gdf93/KeetV2HW/costo_scheda_power_keet_car.xlsx

sezione POWER
 |  |  |  |  |  |  |  |  |  | nuovo componente
schematico | codice mouser | Unitario x100 | Unitario x1000 | note | tot x100 | Colonna1 | totx1000 | note2
M1 | DMPH6250SQ-7 | 0.191 € | 0.128 € |  | 19.10 € |  | 128.00 €
R6 | CRCW040210K0FKEDC | 0.011 € | 0.004 € |  | 1.10 € |  | 4.00 € |  |  | s
Z1 | BZX84C10LT1G | 0.032 € | 0.022 € |  | 3.20 € |  | 22.00 €
R2 | CRCW04026M80FKED | 0.012 € | 0.011 € |  | 1.20 € |  | 11.00 € |  |  | s
R4 | CR0402-FX-1872GLF | 0.005 € | 0.004 € |  | 0.50 € |  | 4.00 € |  |  | s
C3-C11-C12 | TMK107BBJ475MA-T | 0.090 € | 0.069 € | 3 compon. | 27.00 € |  | 207.00 € | valore moltiplicato anche per 3. (sono 3 componenti) |  | s
C2 | C1005X5R1H104K050BB | 0.027 € | 0.019 € |  | 2.70 € |  | 19.00 €
C1 | GRM155R71C104KA88D | 0.008 € | 0.005 € |  | 0.80 € |  | 5.00 €
C6 | CL10A225KP8NNNC | 0.023 € | 0.013 € |  | 2.30 € |  | 13.00 €
R3 | CR0402-FX-1872GLF | 0.013 € | 0.010 € |  | 1.30 € |  | 10.00 € |  |  | s
IC1 | LMR23615DRRR | 1.800 € | 1.300 € |  | 180.00 € |  | 1300.00 €
L1 | IFSC1515AHER4R7M01 | 0.284 € | 0.227 € |  | 28.40 € |  | 227.00 €
C4 | GRM1555C1H510JA01D | 0.022 € | 0.009 € | reel x1000 | 2.20 € |  | 9.00 €
R1 | CRCW040288K7FKEDHP | 0.000 € | 0.000 € | NO STOCK | 0.00 € |  | 0.00 € |  |  | s
R5 | CRCW040222K1FKED | 0.012 € | 0.004 € |  | 1.20 € |  | 4.00 € |  |  | s
C5 | GRM31CR61A476KE15L | 0.289 € | 0.209 € |  | 28.90 € |  | 209.00 €
C9 | EMK105BJ105KVHF | 0.025 € | 0.013 € |  | 2.50 € |  | 13.00 €
D1 | BAT54CLT1G | 0.034 € | 0.024 € |  | 3.40 € |  | 24.00 €
IC2 | TLV75740PDRVR | 0.308 € | 0.184 € |  | 30.80 € |  | 184.00 €
C10 | TMK105CBJ225KV-F | 0.057 € | 0.042 € |  | 5.70 € |  | 42.00 €
C7 | GRM155R60J475ME87D | 0.041 € | 0.024 € |  | 4.10 € |  | 24.00 €
IC4 | MCP73831T-2ACI_MC | 0.381 € | 0.381 € | no x1000 | 38.10 € |  | 381.00 €
R7 | CRCW040218K0FKED | 0.012 € | 0.004 € |  | 1.20 € |  | 4.00 € |  |  | s
R8 | CRCW0402100KFKEDC | 0.011 € | 0.004 € |  | 1.10 € |  | 4.00 € |  |  | s
M2 | DMP1045U-7 | 0.123 € | 0.086 € |  | 12.30 € |  | 86.00 €
IC3 | S-1011EA0-M6T1U4 | 0.512 € | 0.355 € |  | 51.20 € |  | 355.00 €
C8 | GRM155R71H472JA01J | 0.013 € | 0.008 € |  | 1.30 € |  | 8.00 €
R9 |  |  |  |  | 0.00 € |  | 0.00 € |  |  | s
 |  |  | dimensione ordine: |  | 100 unità |  | 1000 unità
 |  |  | totale ordine: |  | 451.60 € |  | 3297.00 € | -26.99291408% | risparmio economia di scala
 |  |  | costo unitario: |  | 4.52 € |  | 3.30 €
sezione OBD | PART NUMBER(NO MOUSER PART…)
schematico | part number | unitario x100 | unitario x1000 | note | tot x100 | Colonna7 | tot x1000
connettore OBD |  | 0.82 € | 0.74 € |  | 82.00 € |  | 740.00 €
C33-C34 | CC0402KRX7R9BB561 | 0.009 € | 0.008 € | 2 | 1.80 € |  | 16.00 €
R33-R34 | ERJ-2RHD1000X | 0.030 € | 0.014 € | 2 | 6.00 € |  | 28.00 €
IC7 | TJF1051T/3 | 0.477 € | 0.352 € |  | 47.70 € |  | 352.00 €
C31-C32-C27-C23-C24-C25 | EMK105BJ105KVHF | 0.025 € | 0.013 € | 6 | 15.00 € |  | 78.00 €
IC6 | LPC1517JBD48E | 3.150 € | 2.380 € |  | 315.00 € |  | 2380.00 €
C28-C30 | 04025A100JAT2A | 0.012 € | 0.007 € | 2 | 2.40 € |  | 14.00 €
Y2 | ECS-120-10-36B-CWY-TR | 0.246 € | 0.197 € | reelx1000 | 24.60 € |  | 197.00 €
U1 | AP7313-33SRG-7 | 0.113 € | 0.085 € |  | 11.30 € |  | 85.00 €
R35 | CRCW040247K0FKED | 0.012 € | 0.004 € |  | 1.20 € |  | 4.00 €
R36-R37 | TNPW040210K0DEED | 0.141 € | 0.078 € | 2 | 28.20 € |  | 156.00 €
C35-C36-C26 | C1005X5R1H104K050BB | 0.027 € | 0.019 € | 3 | 8.10 € |  | 57.00 €
P1 | TLV76050DBZT | 0.161 € | 0.111 € |  | 16.10 € |  | 111.00 €
R38-R39 | RC0805FR-070RL | 0.006 € | 0.005 € | 2 | 1.20 € |  | 10.00 €
U2<A:B> | LM393D | 0.142 € | 0.097 € |  | 14.20 € |  | 97.00 €
R40-R41 | RC0402FR-07330RL | 0.003 € | 0.003 € | 2 | 0.60 € |  | 6.00 €
DS1 | HSMS-C190 | 0.108 € | 0.080 € |  | 10.80 € |  | 80.00 €
DS2 | HSMY-C190 | 0.108 € | 0.080 € |  | 10.80 € |  | 80.00 €
R32 | CRCW0402510RFKEDC | 0.011 € | 0.004 € |  | 1.10 € |  | 4.00 €
U3 | MCP2021-500E/SN | 0.805 € | 0.805 € |  | 80.50 € |  | 805.00 €
C29 | GRM155R60J106ME05J | 0.044 € | 0.025 € |  | 4.40 € |  | 25.00 €
R26-R27 | ERJ-2RKF3301X | 0.008 € | 0.003 € | 2 | 1.60 € |  | 6.00 €
R28-R29-R31-R30 | TNPW040210K0DEED | 0.141 € | 0.078 € | 4 | 56.40 € |  | 312.00 €
D4 | BAT46W-7-F | 0.113 € | 0.069 € |  | 11.30 € |  | 69.00 €
Q5 | BSS84LT1G | 0.067 € | 0.047 € |  | 6.70 € |  | 47.00 €
Q6-Q7 | BSS138 | 0.062 € | 0.042 € | 2 | 12.40 € |  | 84.00 €
 |  |  | dimensione ordine: |  | 100 unità |  | 1000 unità
 |  |  | totale ordine: |  | 771.40 € |  | 5843.00 € | -24.25460202% | risparmio economia di scala
 |  |  | costo unitario: |  | 7.71 € |  | 5.84 €
sezione CONTROL
schematico | part number | unitario x100 | unitario x1000 | Colonna1 | tot x100 | Colonna7 | tot x1000
LED1 | 150060RS75000 | 0.097 € | 0.097 € |  | 9.70 € |  | 97.00 €
R13-R17-R21-R18 | Panasonic ERJ-2RKF4701X | 0.008 € | 0.004 € | 4 | 3.20 € |  | 16.00 €
Q1-Q3 | ON Semiconductor BC850CLT1G | 0.028 € | 0.019 € | 2 | 5.60 € |  | 38.00 €
R14-R20-R16-R22 | Vishay CRCW040247K0FKED | 0.012 € | 0.004 € | 4 | 4.80 € |  | 16.00 €
R12 | Panasonic ERJ-2RKF1500X | 0.008 € | 0.003 € |  | 0.80 € |  | 3.00 €
R15 | Vishay CRCW0402-10K0FKED | 0.012 € | 0.005 € |  | 1.20 € |  | 5.00 €
Y1 | XRCHA16M000F0A12R0 | 0.387 € | 0.309 € |  | 38.70 € |  | 309.00 €
C16-C22-C13-C14-C15-C17-C14 | EMK105BJ105KVHF | 0.025 € | 0.013 € | 7 | 17.50 € |  | 91.00 €
C18-C19 | GRM1551X1H8R0DA01D | 0.239 € | 0.195 € | 2.no mouse | 47.80 € |  | 390.00 €
R19 | Yageo RC0402FR-072K4L | 0.003 € | 0.003 € |  | 0.30 € |  | 3.00 €
R23 | TE Connectivity CRG0402F5K6 | 0.002 € | 0.002 € |  | 0.20 € |  | 2.00 €
R24-R25 | Yageo RC0402FR-132K2L | 0.003 € | 0.003 € | 2 | 0.60 € |  | 6.00 €
R10 | ERJ-2RKD1203X | 0.035 € | 0.019 € |  | 3.50 € |  | 19.00 €
R11 | ERJ-2RHD3902X | 0.023 € | 0.014 € |  | 2.30 € |  | 14.00 €
D2 | ON Semiconductor MM3Z3V9ST1G | 0.032 € | 0.022 € |  | 3.20 € |  | 22.00 €
IC5 | ATMEGA1284P-MU | 3.720 € | 3.720 € |  | 372.00 € |  | 3720.00 €
Q2 | Diodes DMP1045U-7 | 0.123 € | 0.086 € |  | 12.30 € |  | 86.00 €
D3 | 02SSL20L | 0.039 € | 0.039 € |  | 3.90 € |  | 39.00 €
C20 | Samsung CL10B104JO8NNND | 0.003 € | 0.003 € |  | 0.30 € |  | 3.00 €
C21 | Samsung CL10A106KP8NNND | 0.025 € | 0.025 € |  | 2.50 € |  | 25.00 €
 |  |  | dimensione ordine: |  | 100 unità |  | 1000 unità
 |  |  | totale ordine: |  | 530.40 € |  | 4904.00 € | -7.54147813% | risparmio economia di scala
 |  |  | costo unitario: |  | 5.30 € |  | 4.90 €
 |  |  |  |  |  |  |  |  | resoconto finale: somma dei contributi di tutte le sezioni
 |  |  |  |  |  |  |  |  | dimensione ordine: | 100 unità | 1000 unità
 |  |  |  |  |  |  |  |  | totale ordine: | 1753.40 € | 14044.00 €
 |  |  |  |  |  |  |  |  | costo unitario: | 17.53 € | 14.04 €
