gdf93/KeetV2HW/connettore_OBD_pin_invertiti.SLDASM

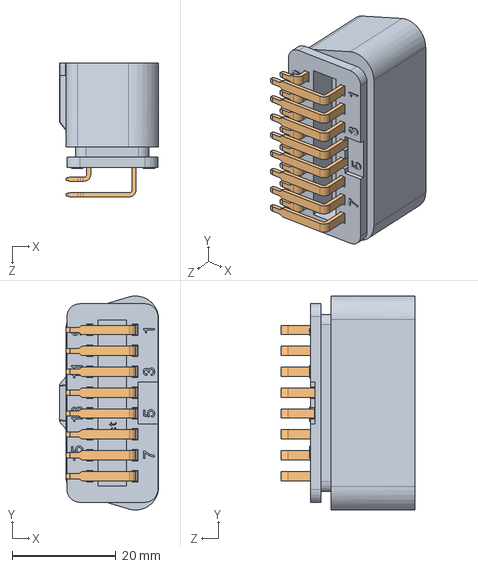
[picture p1: CAD file, 2021-03-10]
connettore_OBD_pin_invertiti.SLDASM
19.1 x 41.2 x 25.7 mm
corpo_principale
pin
