gdf93/KeetV2HW/modelli-pogo/mill-max-827-22-010-10-020101.sldasm

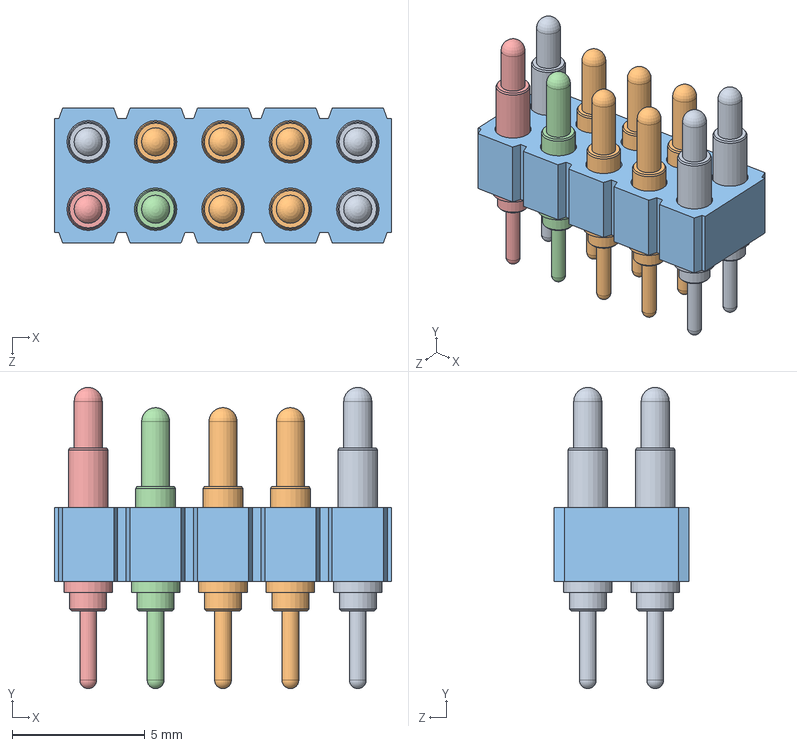
[picture p2: CAD file, 2021-02-11]
modelli-pogo/mill-max-827-22-010-10-020101.sldasm
12.7 x 11.4 x 5.08 mm
mill-max-827-22-010-10-020101_P4XX-28-010-00-090000
mill-max-827-22-010-10-020101_0914-0 x 6
mill-max-827-22-010-10-020101_0914-1 x 4
