gdf93/KeetV2HW/modelli-pogo/mill-max-827-22-010-10-020101_0914-0.sldprt

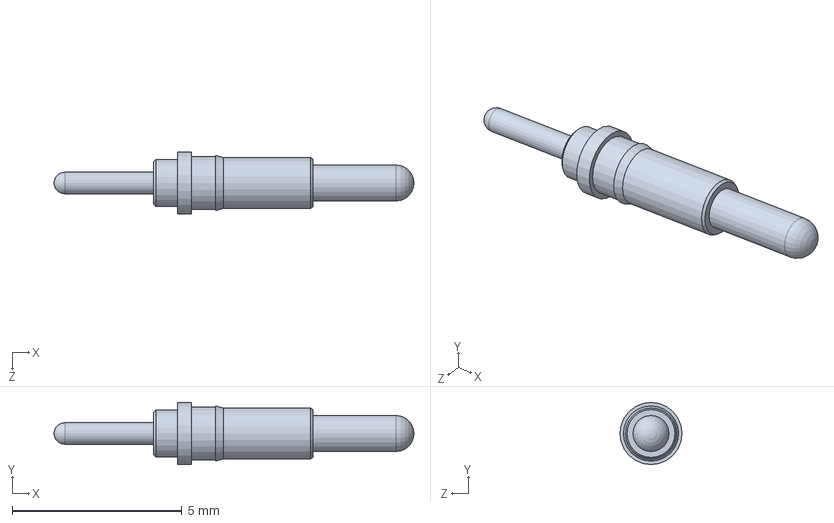
[picture p3: CAD file, 2021-02-11]
modelli-pogo/mill-max-827-22-010-10-020101_0914-0.sldprt
10.6 x 1.83 x 1.83 mm
