gdf93/KeetV2HW/modelli-pogo/mill-max-827-22-010-10-020101_0914-1.sldprt

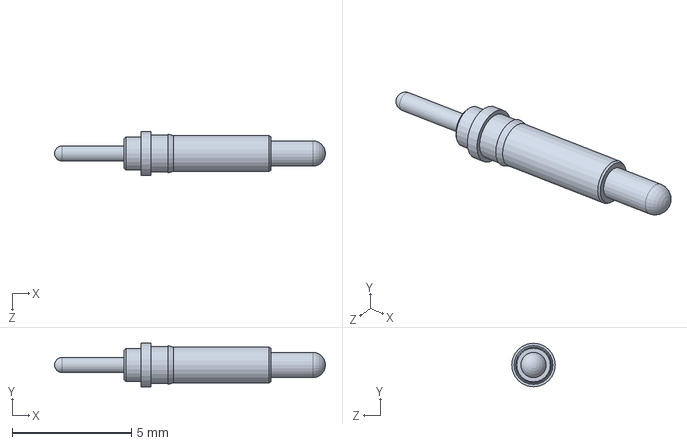
[picture p4: CAD file, 2021-02-11]
modelli-pogo/mill-max-827-22-010-10-020101_0914-1.sldprt
11.4 x 1.83 x 1.83 mm
