gdf93/KeetV2HW/modelli-pogo/mill-max-827-22-010-10-020101_P4XX-28-010-00-090000.sldprt

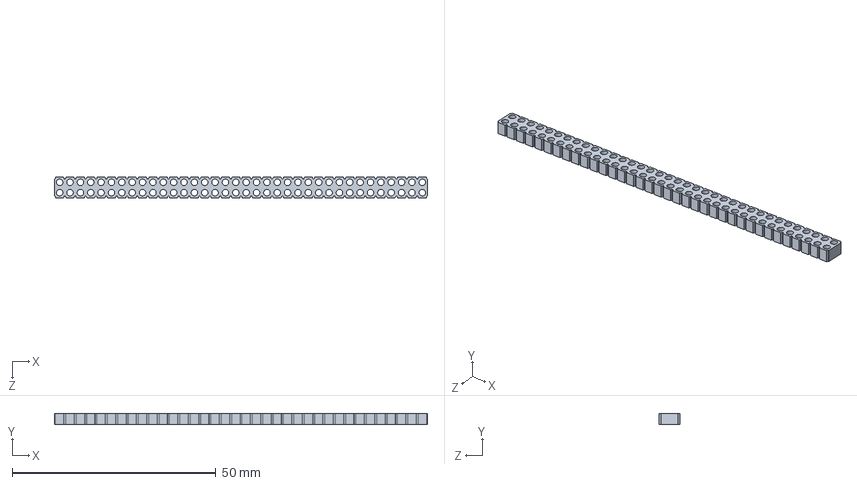
[picture p5: CAD file, 2021-02-11]
modelli-pogo/mill-max-827-22-010-10-020101_P4XX-28-010-00-090000.sldprt
91.4 x 2.79 x 5.08 mm
