gdf93/KeetV2HW/SIM868e_3D.STEP

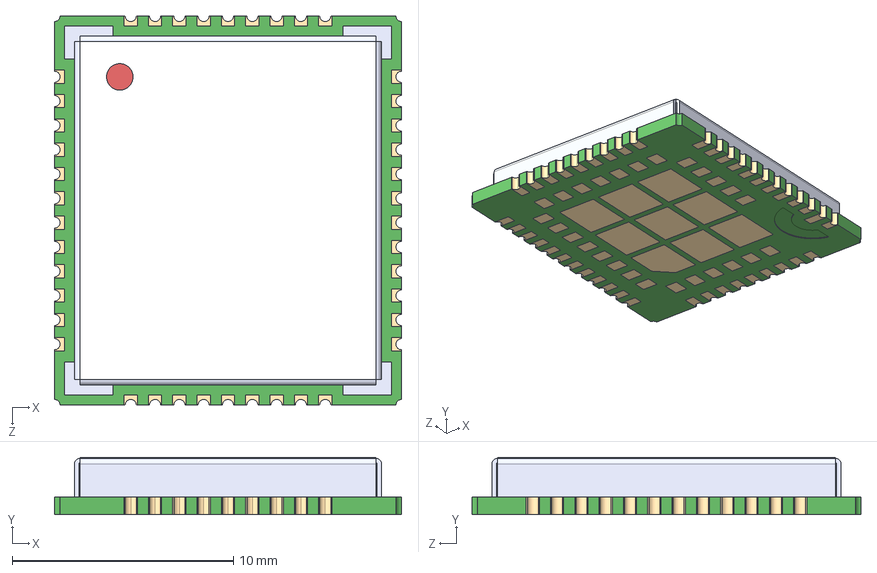
[picture p6: CAD file, 2021-03-07]
SIM868e_3D.STEP
15.7 x 2.60 x 17.6 mm
