gdf93/KeetV2HW/2337019-1.stp

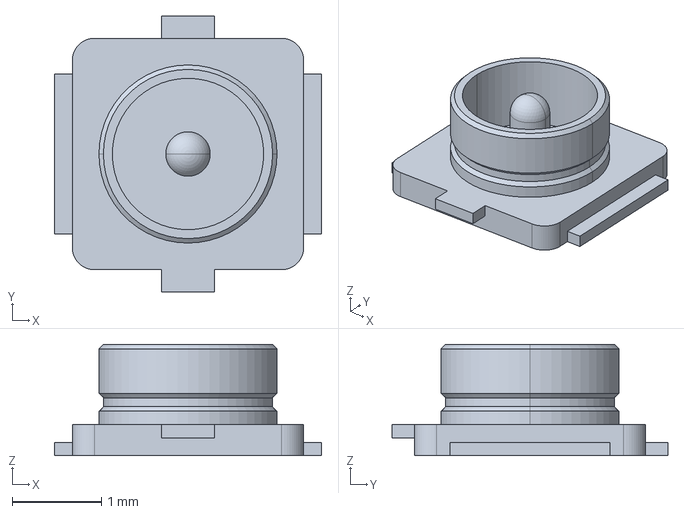
[picture p7: CAD file, 2021-03-07]
2337019-1.stp
3.00 x 3.10 x 1.25 mm
