gdf93/KeetV2HW/(list of files, cad)

Other CAD files:
parte_dell_obdCR-PG016.SLDPRT
mill-max-827-22-010-10-020101.step
connettore_OBD_pin_invertiti.SLDPRT
