gdf93/KeetV2HW/PDNAnalyzer_Output/PowerSupplyV2/Unnamed simulation (1)/Results/vpin2pin.csv

vrefdes | vpin | refdes | pin
VCOMP0 | 0 | Conn1 | 16
VCOMP0 | 1 | Conn1 | 4
VCOMP1 | 0 | M1 | 3
VCOMP1 | 1 | Conn1 | 4
