gdf93/KeetV2HW/PDNAnalyzer_Output/PowerSupplyV2/Unnamed simulation (1)/Results/vcomp2id.csv

vrefdes | id
VCOMP0 | 0
VCOMP1 | 1
