gdf93/KeetV2HW/PDNAnalyzer_Output/PowerSupplyV2/Unnamed simulation (1)/Results/vias.csv

x | y | layer1 | layer2 | voltage1 | voltage2 | current
20.1758 | 988.444 | TOP_LAYER | BOTTOM_LAYER | 0.0005 | 0.0005 | 2.67766e-16
20.1758 | 1016.82 | TOP_LAYER | BOTTOM_LAYER | 0.0005 | 0.0005 | -2.67766e-16
20.1758 | 1045.2 | TOP_LAYER | BOTTOM_LAYER | 0.0005 | 0.0005 | 1.33883e-15
24.1758 | 863.064 | TOP_LAYER | BOTTOM_LAYER | 0.0005 | 0.0005 | 8.03298e-16
24.1758 | 891.444 | TOP_LAYER | BOTTOM_LAYER | 0.0005 | 0.0005 | 1.78511e-16
24.1758 | 919.824 | TOP_LAYER | BOTTOM_LAYER | 0.0005 | 0.0005 | 5.35532e-16
46.1758 | 988.444 | TOP_LAYER | BOTTOM_LAYER | 0.0005 | 0.0005 | 1.78511e-16
46.1758 | 1016.82 | TOP_LAYER | BOTTOM_LAYER | 0.0005 | 0.0005 | -5.35532e-16
46.1758 | 1045.2 | TOP_LAYER | BOTTOM_LAYER | 0.0005 | 0.0005 | 8.92553e-16
47.1758 | 717.824 | TOP_LAYER | BOTTOM_LAYER | 0.0005 | 0.0005 | -1.78511e-15
47.1758 | 748.824 | TOP_LAYER | BOTTOM_LAYER | 0.0005 | 0.0005 | -9.81808e-16
50.1758 | 863.064 | TOP_LAYER | BOTTOM_LAYER | 0.0005 | 0.0005 | 8.92553e-16
50.1758 | 891.444 | TOP_LAYER | BOTTOM_LAYER | 0.0005 | 0.0005 | 4.46277e-16
50.1758 | 919.824 | TOP_LAYER | BOTTOM_LAYER | 0.0005 | 0.0005 | 8.92553e-16
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
