gdf93/KeetV2HW/OBD.pdf

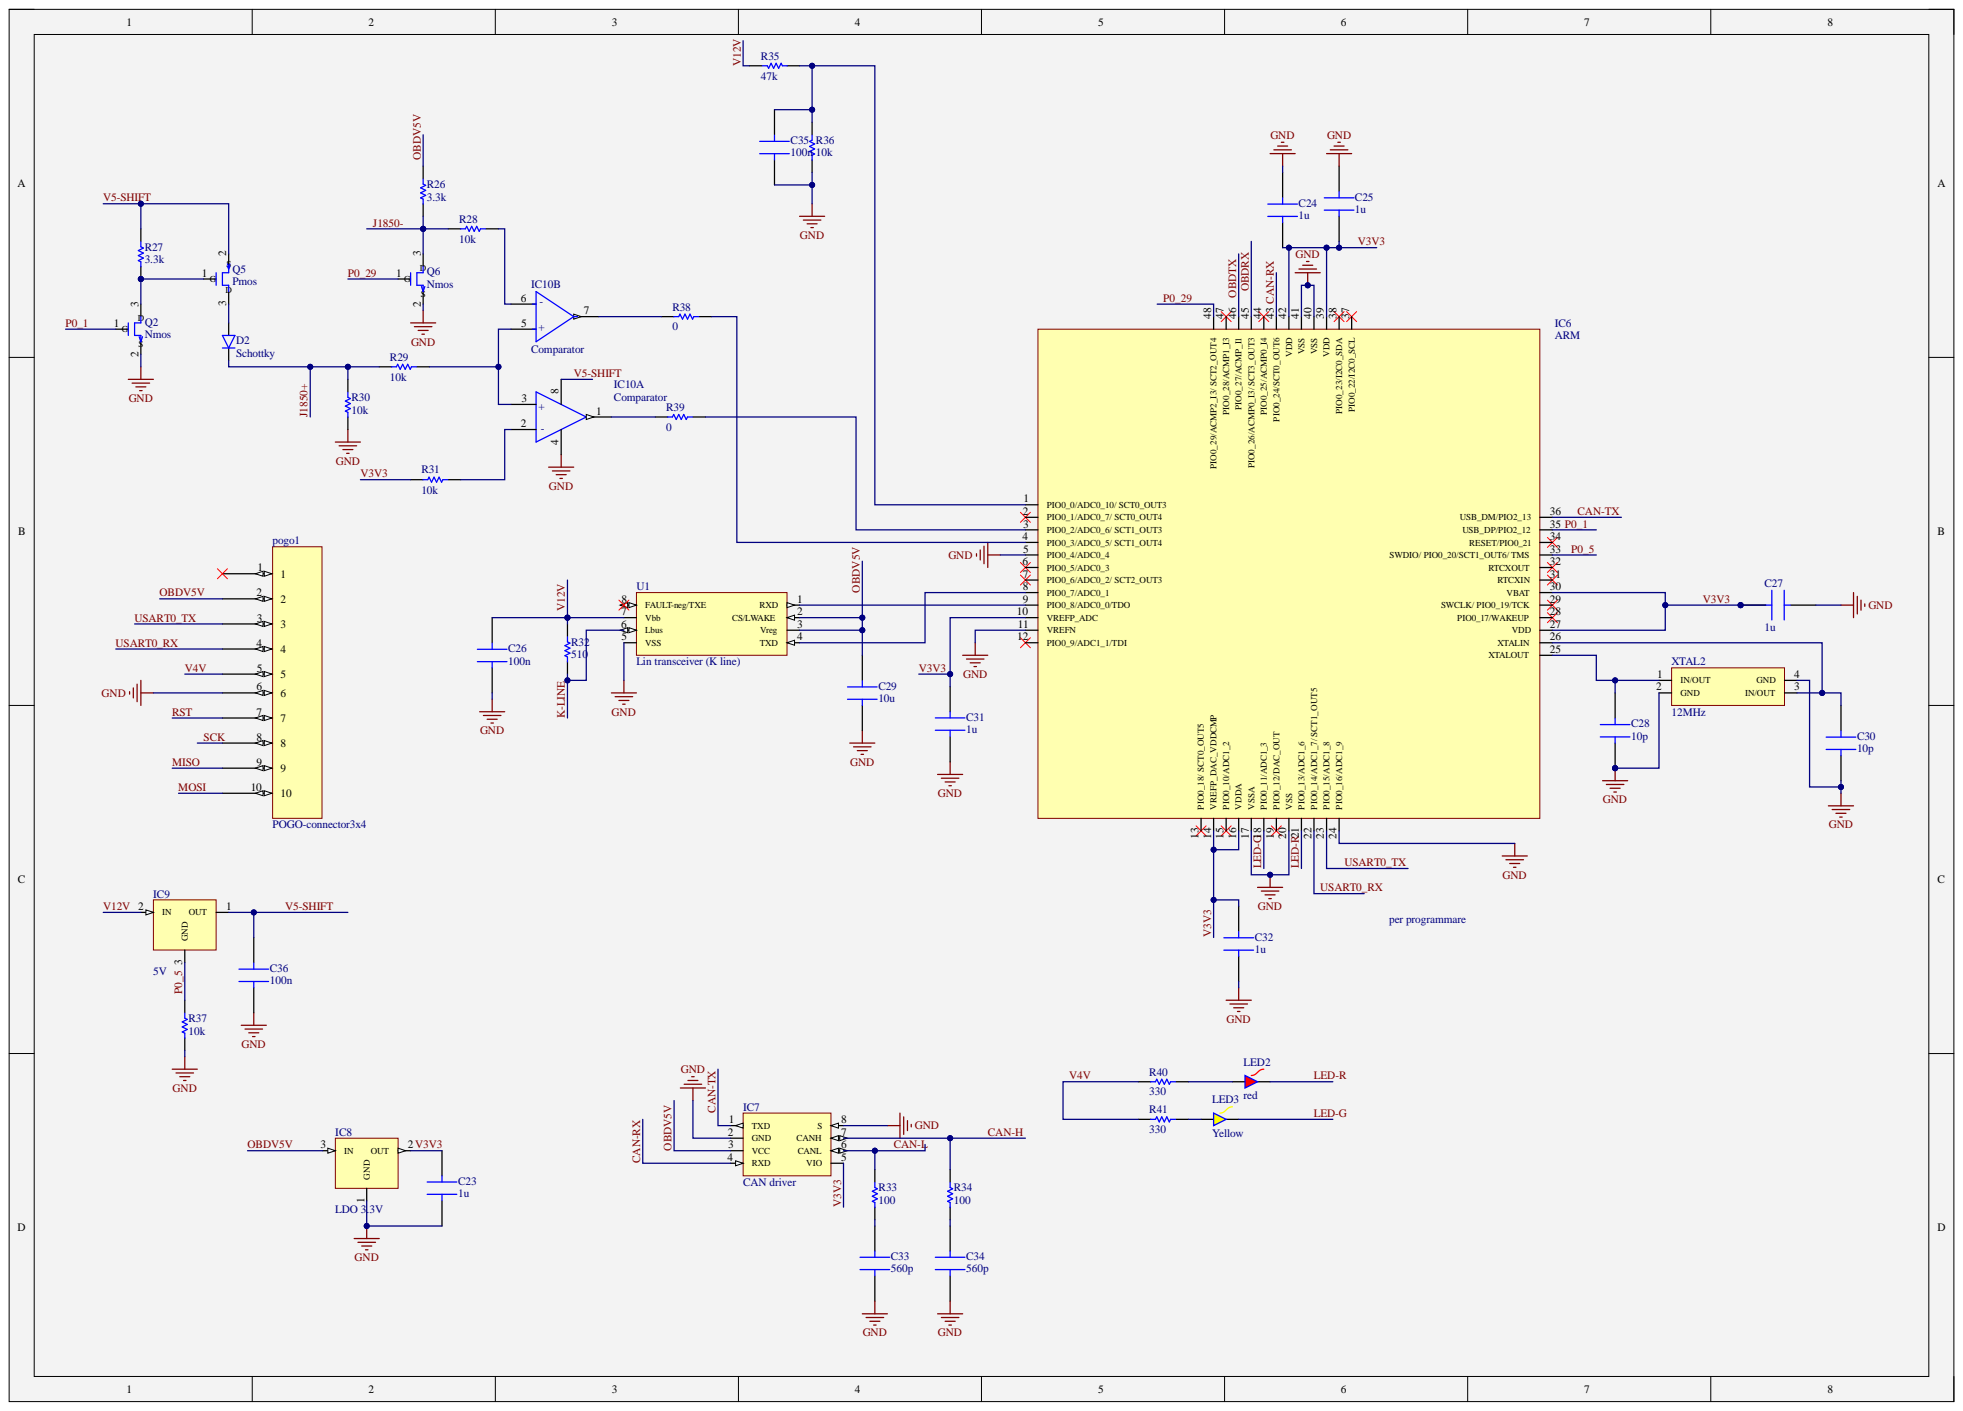
[picture p8: page 1]

SCL 37 PIO0_23/I2C0_SDA 38 VDD 39 VSS 40 VSS 41 VDD 42 PIO0_24/SCT0_OUT6 43 PIO0_25/ACMP0_I4 44 PIO0_26/ACMP0_I3/ SCT3_OUT3 45 PIO0_27/ACMP_I1 46 PIO0_28/ACMP1_I3 47 PIO0_29/ACMP2_I3/ SCT2_OUT4 48

GND V3V3
