gdf93/KeetV2HW/(list of files, drawings)

Other design files:
Control.SchDoc
KeetV2.PcbLib
KeetV2.PrjPCB
KeetV2.SchLib
KeetV21/KeetV2_2.SCHLIB
KeetV21/PowerSupply.PcbLib
KeetV21/SamacSys.PcbLib
Net.SchDoc
Net_board/Net/Net.PcbDoc
Net_board/Net/Net.PrjPcb
Net_board/Net/Net.SchDoc
OBD.SchDoc
PowerSupply.PcbDoc
PowerSupply.SchDoc
PowerSupplyV2.PcbDoc
Program_interface_V2/interface.SchDoc
Program_interface_V2/Program_interface_V2.PcbDoc
Program_interface_V2/Program_interface_V2.PrjPcb
