gdf93/KeetV2HW/(commit log)

2020-12-05 Add shitty net (test)
    [PowerSupply.SchDoc]
2020-12-05 create altium project
    create altium project
    [KeetV2.PrjPCB, PowerSupply.SchDoc]
2020-12-05 add bridge diode
    add bridge diode
    [PowerSupply.SchDoc]
2020-12-06 Schematic clean
    [PowerSupply.SchDoc]
2020-12-11 DC/DC and rev. pol. prot. implementation
    Input stages of the supply are implemented (reverse polarity protection + DC/DC)
    [PowerSupply.SchDoc]
2020-12-11 DC/DC Vin2 net fix
    [PowerSupply.SchDoc]
2020-12-11 LMR FB net fix
    fix of feedback wire in LMR regulator
    [PowerSupply.SchDoc]
2020-12-12 add LDO
    add LDO, diode, decoupling
    [KeetV2.PrjPCB, PowerSupply.SchDoc]
2020-12-12 DC/DC values labels fix
    [PowerSupply.SchDoc]
2020-12-16 add many components
    add battery charger, voltage detector.
    fix PAD schematic and layout.
    [KeetV2.PrjPCB, PcbLib1.PcbLib, PowerSupply.SchDoc, Schlib1.SchLib]
2020-12-19 Implements voltage detection with circuitry. Battery switch MOS. Input pads
    [PowerSupply.SchDoc]
2020-12-19 Pads for supply distribution add.
    [PowerSupply.SchDoc]
2020-12-19 Add pullup in car voltage detector. Add components' lables
    [KeetV2.PrjPCB, PowerSupply.SchDoc]
2020-12-19 PCB creation
    [KeetV2.PrjPCB, PowerSupply.PcbDoc]
2020-12-19 Add IC1 footprint
    [PowerSupply.PcbDoc, PowerSupply.SchDoc]
2020-12-19 add PCB layout of reverse polarity and DC/DC
    definition of board shape. considerations on area occupation. tracing reverse polarity and DC/DC's nets.
    [KeetV2.PrjPCB, PowerSupply.PcbDoc, PowerSupply.SchDoc]
2020-12-20 Power supply comonents positioning and nets di massima
    All nets on top completed. Missing nets on bottom (12V, ... ).
    [PowerSupply.PcbDoc, PowerSupply.SchDoc]
2020-12-20 Modify capacitor C3(10u->3x4.7u)
    ho cambiato il condensatore C3 in 3 condensatori più bassi
    [PowerSupply.PcbDoc, PowerSupply.SchDoc]
2020-12-20 Add power supply components cost
    ho aggiunto il file excel contenente i costi dei componenti della scheda di power. Costi x100 e x1000 pezzi.
    costi finali di una singola scheda e risparmi di scala
    [costo_scheda_power_keet_car.xlsx]
2020-12-23 modify row "3capacitors"
    non avevo moltiplicato per 3 il costo finale dei condensatori.
    [costo_scheda_power_keet_car.xlsx]
2020-12-23 adjust silkscreen (top overlay)
    ho cercato di sistemare il silkscreen.
    in particolare ho:
    -aggiunto un segno più al pad della batteria.
    Cercato di posizionare il silkscreen in modo che sia interpretabile leggendolo dall'alto verso il basso e da sinistra verso destra. dimensioni in mils 40x6.
    purtroppo con questa configurazione si va ad occupare un po' di area libera.
    [PowerSupply.PcbDoc]
2020-12-23 Tentative TOP silkscreen improvement. Text height set to 35mil. Minor TOP nets move
    Text height reduced to try to fit labels closer to components (easier assembly and final check).
    [KeetV2.PrjPCB, PowerSupply.PcbDoc, PowerSupply.SchDoc]
2020-12-24 Add GND plane on TOP. ICs have direct GND instead of thermal relief
    [PowerSupply.PcbDoc]
2020-12-24 adjust gnd polygon
    ho sistemato alcuni spigoli. Inoltre ho attivato la spunta su "remove dead zone". ho notato che c'èra nel rame non connesso a nessuna net. Abilitando questa opzione ho rimosso queste "isole" di rame.
    Da valutare se aumentare la soglia minima d'area per la rimozione di altre isole di gnd che non vanno da nessuna parte
    [PowerSupply.PcbDoc]
2020-12-26 Add "Control" schematic
    aggiunto il foglio schematico "control"
    aggiunto cristallo a footprint ridotto
    aggiunto footprint atmega
    [Control.SchDoc, KeetV2.PrjPCB, PowerSupply.PcbDoc]
2020-12-26 Add components to control schematics (STILL NEED TO BE CHECKED!)
    Bisogna controllare perchè ci sono diversi errori di net. I pad sono stati copiati e incollati da pad esistenti, bisogna controllare che non ci siano corti indesiderati.
    [Control.SchDoc, KeetV2.PrjPCB, PowerSupply.PcbDoc]
2020-12-27 new components nets are checked
    [Control.SchDoc, PowerSupply.PcbDoc, PowerSupply.SchDoc]
2020-12-27 add thermal relief
    ho aggiunto i thermal relief.
    Ho cambiato lo schematico di una resistenza nello schematico "control".
    [Control.SchDoc, KeetV2.PrjPCB, PowerSupply.PcbDoc]
2020-12-27 Add zener protection to MCU battery voltage analog read
    A zener is added at PA0 pin (Vz=3.9V) in order to clamp voltage in case car battery voltage exceedes around 16V (safe). Resistive partition is sized to have FSR at around 16V
    [Control.SchDoc]
2020-12-27 Zener protection is added to PCB also
    [Control.SchDoc, PowerSupply.PcbDoc]
2020-12-27 Further updates on zener protection
    [PowerSupply.PcbDoc]
2020-12-27 add schematic component
    ho aggiunto, a meno di sviste, tutti i componenti nello schematico.
    Ho mantenuto gli stessi componenti, ma ho ridotto il footprint di alcune resistenze (da 0805 a 0402).
    ho aggiunto i "no ERC" sull'ATmega
    [Control.SchDoc, PowerSupply.PcbDoc]
2020-12-28 fix footprint resistor r14
    ho sistemato il footprint di R14, aggiornato la PCB.
    [Control.SchDoc, PowerSupply.PcbDoc]
2020-12-28 modify wiring atmega <-> sim800e
    ho cambiato il partitore resistivo. da 1.4k a 2.4k (mi pare). ora se l'atmega fornisce 4 V in uscita il sim 800 vede 2.8V. se invece fornisce 3.2V, il sim800 vedrà 2.24V
    ho aggiunto il level shifter nell'altro ramo di trasmissione
    [Control.SchDoc, PowerSupply.PcbDoc]
2020-12-28 start layout of "control" schematic
    ho iniziato il layout della parte di control
    ho aggiunto allo schematico la parte di "obd power dower control", minimizzandone l'area
    [Control.SchDoc, PowerSupply.PcbDoc]
2020-12-28 update of prevous push
    attenzione: il diodo shotcky è da sostituire, in quanto il footprint è troppo piccolo
    [Control.SchDoc, PowerSupply.PcbDoc]
2020-12-29 change diode schematic and footprint
    ho cambiato il diodo, quello di prima era 0201. ho scelto il 02SSL20L
    [Control.SchDoc, PcbLib1.PcbLib, PowerSupply.PcbDoc, Schlib1.SchLib]
2020-12-29 add keep-out region for antenna
    in mechanical 13 c'è l'ingombro dell'antenna
    [PowerSupply.PcbDoc]
2020-12-29 add some pads
    [Control.SchDoc, PowerSupply.PcbDoc]
2021-01-03 add header 14x1, change position of components, fix overlay
    ho aggiunto l'header con pitch 1.27mm.
    da valutare se dedicare due pin ai 12V per distribuire la corrente su più pin.
    Ho spostato alcuni componenti. Ho aggiornato le dimensioni del silkscreen dei nuovi componenti.
    [Control.SchDoc, PowerSupply.PcbDoc, PowerSupply.SchDoc]
2021-01-08 add OBD2 connector, remove 14pin header
    Ho aggiunto il connettore OBD2 con footprint e modello 3D del fornitore Ocean. Ho rimosso il connettore a 14pin.
    [Control.SchDoc, PcbLib1.PcbLib, PowerSupply.PcbDoc, PowerSupply.SchDoc, Schlib1.SchLib]
2021-01-09 add second version of pcb
    ho aggiunto la seconda versione della pcb, PowerSupplyV2. ho posizionato il connettore al centro scheda e l'ho bloccato in modo che non si muova. ho iniziato a ruotare la parte di power per adattarla al nuovo layout, ma bisogna ancora apportare modifiche. ho allargato la scheda a 37mm in modo da utilizzare quasi tutto lo spazio che occupa il connettore.
    [KeetV2.PrjPCB, PowerSupply.SchDoc, PowerSupplyV2.PcbDoc, Schlib1.SchLib]
2021-01-10 add header for network board. fix led position
    aggiunte considerazioni fatte durante la chiamata con gulli
    [PowerSupply.SchDoc, PowerSupplyV2.PcbDoc]
2021-01-11 respahe power layout. change header. reshape control
    [PowerSupply.SchDoc, PowerSupplyV2.PcbDoc]
2021-01-11 trace route. reduce board size by 2mm
    ho posizionato la parte di controllo e tracciato quasi tutte le piste mancanti.
    Ho fissato la posizione del led a centro scheda. ho ridotto il lato orizzontale della scheda di 2mm, in modo da forzare un po' l'occupazione dell'area, poi eventualmente la si potrà allargare di nuovo durante la creazione della parte obd.
    C'è ancora dello spazio libero sul top.
    [PowerSupply.SchDoc, PowerSupplyV2.PcbDoc]
2021-01-11 fix a dead net
    [PowerSupplyV2.PcbDoc]
2021-01-12 Layout update (power and control). Pins on ATmega are changed to best fit the layout
    [Control.SchDoc, PowerSupplyV2.PcbDoc]
2021-01-12 change battery pad
    ho cambiato i pad della batteria, mettendoli though hole.
    [PowerSupply.SchDoc, PowerSupplyV2.PcbDoc]
2021-01-12 change headers nets
    [PowerSupply.SchDoc, PowerSupplyV2.PcbDoc]
2021-01-14 add OBD schematic and main components
    ho aggiunto lo schematico OBD. ho aggiunto l'ARM e gli integrati principali. il cristallo andrebbe sostiuito con uno più piccolo. (questo è solo molto basso).
    [Control.SchDoc, KeetV2.PrjPCB, OBD.SchDoc, PowerSupplyV2.PcbDoc]
2021-01-14 place more components OBD side
    [OBD.SchDoc, PowerSupplyV2.PcbDoc]
2021-01-14 add components
    [OBD.SchDoc, PowerSupply.SchDoc, PowerSupplyV2.PcbDoc]
2021-01-14 add more components2
    lo schematico è stato copiato al 80%.
    [KeetV2.PrjPCB, OBD.SchDoc, PowerSupplyV2.PcbDoc]
2021-01-15 OBD components and schematics update
    -change chrystal and caps
    -change 3V net name into V3V3 for consistency
    -PO_29 pin connection fix
    -decoupling tutto a 1uF (nel sito un po a 1u e un po' a 100n?)
    -K-line driver 10uF is now 0402 footprint
    -LM393D - pin connection fix (PIO3)
    -USE OBDV5V instead V5V in order to allow power down with microcontroller
    - PO_1 pin fix
    [Control.SchDoc, KeetV2.PrjPCB, OBD.SchDoc, PowerSupply.SchDoc, PowerSupplyV2.PcbDoc]
2021-01-15 CAN-L net label fix (but missing connection from obd connector still remains)
    [OBD.SchDoc, PowerSupply.SchDoc, PowerSupplyV2.PcbDoc]
2021-01-15 add few components, fix comparator net
    [OBD.SchDoc, PowerSupplyV2.PcbDoc]
2021-01-15 fix net, start component positionioning
    ho iniziato a sistemare i componenti sul bottom layer. Per il momento li ho solo raggruppati per vicinanza e funzione.
    ho sistemato alcune net che risultavano non collegate.
    [OBD.SchDoc, PowerSupplyV2.PcbDoc]
2021-01-19 add schematic components
    aggiunte 0 ohm in uscita al comparatore
    aggiunto lettore tensione batteria
    aggiunti LED
    aggiunto regolatore usato in modo strano (P0_5)
    Lo schematico dovrebbe essere completo, ma va controllato.
    [OBD.SchDoc, PowerSupplyV2.PcbDoc]
2021-01-20 fix footprint, add green area that represent space constraints for bottom layer
    [OBD.SchDoc, PowerSupplyV2.PcbDoc]
2021-01-20 start placing bottom components
    [OBD.SchDoc]
2021-01-20 NET-FIX, creazione bom sezione obd
    [Control.SchDoc, KeetV2.PrjPCB, OBD.SchDoc, costo_scheda_power_keet_car.xlsx]
2021-01-20 costo scheda obd.
    dovrebbero esserci tutti i componenti.
    [costo_scheda_power_keet_car.xlsx]
2021-01-20 adjust text
    [costo_scheda_power_keet_car.xlsx]
2021-01-21 aggiunto costo sezione "control"
    [costo_scheda_power_keet_car.xlsx]
2021-01-21 add pogo connector for measurments
    [OBD.SchDoc, costo_scheda_power_keet_car.xlsx]
2021-01-21 add pogo pad
    [Control.SchDoc, OBD.SchDoc, PcbLib1.PcbLib, Schlib1.SchLib]
2021-01-21 add nets
    [PowerSupplyV2.PcbDoc]
2021-01-21 Add some bottom nets. Add 0Ohm R in series with OBDV5V for measurements
2021-01-22 Power section nets revision (from input to DC/DC output). Minor changes.)
    [Control.SchDoc]
2021-01-22 add nets and vias
    ho tirato altre piste e ho iniziato a fare anche qualche "via" tra top e bottom
    [Control.SchDoc, OBD.SchDoc]
2021-01-22 finisch bottom layer net
    da tracciare manca solo la massa e la v4v sul top layer e non sarà facile tracciarla.
    da valutare eventuali ottimizzazioni.
    ho dovuto sostituire due footprint, da 0603 a 0805 a due resistenze da zero ohm per farci passare delle net sotto
    [OBD.SchDoc, costo_scheda_power_keet_car.xlsx]
2021-01-24 update obd pin connector. add more net
    bisogno girare i pad di programmazione sul bottom layer, finire l'ultima net(v4v) e fare le masse.
    [Control.SchDoc, PcbLib1.PcbLib, PowerSupply.SchDoc, costo_scheda_power_keet_car.xlsx]
2021-01-25 programming pad set on bottom layer
    [OBD.SchDoc]
2021-01-26 move led on bottom layer, trace net v4v, decrease component density. start ground tracing
2021-01-26 Swap OBDPWRCTRL pins in atmega. Minor pwr fixes. Slightly moved IC4 decap (closer). Minor pwr rails changes
    [Control.SchDoc, PowerSupply.PcbDoc]
2021-01-27 read description
    sistemate delle cose con gulli.
    fatta la v3v3 da 12mil
    controllato decoupling v3v3
    fatta la obd5V da 16mil
    controllata la k-line
    controllata la j1850-
    controllata la j1850+
    controllata la CAN
    iniziato a tirare le masse sul bottom
2021-01-28 complete ground on bottom
    ho completato tutta la massa sul bottom.
    attenzione, nel bottom il loop di massa non è chiuso in alto a destra. ci sono due rami di massa che partono dal connettore obd. questi due rami non si uscono in alto a destra nella scheda.
    [Control.SchDoc, PowerSupply.SchDoc]
2021-01-28 TOP ground plane for supply (NB vias shared with signal gnd pplane for bottom, is ok?). ISP double connection. CHECK
    C'è una net ISP che fa un girro assurdo verso l'arm, e alla fine quel pin ISP va a due pin diversi su arm (pin 5 e pin 24). Controllare se OK.
    Il top ha un piano di massa per la parte di potenza. Un ground solido va al pin header per il modulo di rete. Il bottom ha un piano di massa unico e ha via che vanno verso il piano di massa power, questa è una pratica pericolosa e andrebbe ridotta al massimo
2021-01-29 fix thermal relief ground via
2021-01-29 add ground pin header
    ho sistemato alcune via
    [PowerSupply.SchDoc]
2021-01-30 lot of fix with gulli
    [KeetV2.PrjPCB, OBD.SchDoc, PowerSupply.SchDoc]
2021-01-30 read description
    allargato la v4v a 14mil, ove possibile
    controllato la net v5v
    controllato la net v12v
    pulito la PCB, sistemato le net "brutte"
    [OBD.SchDoc, costo_scheda_power_keet_car.xlsx]
2021-02-01 create capacitor footprint
    0402, 0603, 0805, 1206
    da modificare leggermente, ma ci siamo
    [KeetV2.PcbLib, KeetV2.PrjPCB, KeetV2.SchLib, PcbLib1.PcbLib, Schlib1.SchLib]
2021-02-01 create resistor footprint
    0402
    0603
    0805
    1206
    [KeetV2.PcbLib]
2021-02-01 numerose modifiche
    ho iniziato a sostituire i footprint nello schematico.
    ho iniziato dalla sezione di power, e ho sostituito solo le resistenze e i condensatori. Nel layout i layer sono confusi, ma si sistemeranno una volta finita tutta la migrazione.
    [KeetV2.PcbLib, KeetV2.PrjPCB, KeetV2.SchLib, KeetV2_1.SCHLIB, PowerSupply.PcbLib, PowerSupply.SchDoc, SamacSys.PcbLib, costo_scheda_power_keet_car.xlsx]
2021-02-02 schematic fix
    [KeetV2.SchLib, OBD.SchDoc, PowerSupply.SchDoc]
2021-02-02 DC/DC section completed
    [KeetV2.PcbLib, KeetV2.SchLib, PowerSupply.SchDoc]
2021-02-02 more changes
    [KeetV2.PcbLib, KeetV2.PrjPCB, KeetV2.SchLib, PowerSupply.SchDoc]
2021-02-02 more changes to control schematic
    [Control.SchDoc, KeetV2.PcbLib, KeetV2.SchLib, PowerSupply.SchDoc]
2021-02-02 power sch and control sch fix + relative footprint fix
    [Control.SchDoc, KeetV2.PcbLib, KeetV2.SchLib]
2021-02-03 start changes on obd section
    [KeetV2.PcbLib, KeetV2.SchLib, OBD.SchDoc]
2021-02-03 almost finish
    manca solo l'ARM e il comparatore.
    [KeetV2.PcbLib, KeetV2.SchLib, OBD.SchDoc]
2021-02-03 migration almost over
    [Control.SchDoc, KeetV2.PcbLib, KeetV2.SchLib, KeetV2_1.SCHLIB, PowerSupply.PcbLib, SamacSys.PcbLib]
2021-02-04 finish migration
    [OBD.SchDoc, PowerSupply.SchDoc]
2021-02-04 add bom
    [KeetV2-BOM.xlsx, KeetV2.PrjPCB, PowerSupplyV2.PcbDoc]
2021-02-04 fix silkscreen top and bottom
    [KeetV2.PcbLib, KeetV2.SchLib, OBD.SchDoc, PowerSupply.SchDoc, PowerSupplyV2.PcbDoc]
2021-02-05 changes and fixs
    [KeetV2.PrjPCB, PowerSupplyV2.PcbDoc]
2021-02-05 small fixes
    [Control.SchDoc, KeetV2.PrjPCB, KeetV2.SchLib, PowerSupply.SchDoc, PowerSupplyV2.PcbDoc]
2021-02-09 add version text. changes some pins
    cambiati i can-tx e p05 messi a massa i veri open drain
    [Control.SchDoc, OBD.SchDoc, PowerSupply.SchDoc, PowerSupplyV2.PcbDoc]
2021-02-09 finalmente sono riuscito a mettere il logo
    [PowerSupplyV2.PcbDoc]
2021-02-10 aggiunti testpad, verificata la massa, e controllato verso connettore obd
    ho aggiunto i seguenti testpad:
    net DCEN
    OBD RX
    OBD TX
    V4V
    OBDpwrctrl
    CANRX
    CANTX
    V5-SHIFT
    OBDV5V
    V3V3
    [KeetV2.PcbLib, OBD.SchDoc]
2021-02-11 aggiunti fori di centraggio. creazione progetto scheda programmazione
    [KeetV2.PcbLib, KeetV2.PrjPCB, KeetV2.SchLib, KeetV2_1.SCHLIB, OBD.SchDoc, PowerSupply.PcbLib, PowerSupplyV2.PcbDoc, Program_interface_V2.PcbDoc]
2021-02-11 sto sistemando il connettore pogo
    [KeetV2_1.SCHLIB, OBD.SchDoc, PowerSupply.PcbLib, SamacSys.PcbLib, interface.SchDoc]
2021-02-11 piccole mod alle librerie. da sistemare il pogo
    [KeetV2_2.SCHLIB, PowerSupply.PcbLib, Program_interface_V2.PcbDoc, SamacSys.PcbLib, interface.SchDoc]
2021-02-15 aggiunto decoupling K-line, can driver LDO. aggiunte ulteriori via di massa
    [Control.SchDoc, OBD.SchDoc, PowerSupply.SchDoc, PowerSupplyV2.PcbDoc]
2021-02-16 modifiche importanti alla massa
    call con gulli
    [PowerSupplyV2.PcbDoc, Program_interface_V2.PcbDoc, interface.SchDoc]
2021-02-17 aggiunto footprint arduino
    [Program_interface_V2.PcbDoc, interface.SchDoc]
2021-02-17 aggiunte net
    [interface.SchDoc]
2021-02-17 modificate le posizioni di alcuni componenti (zona net P0_5)
    aggiunto simulatore PDN
    [KeetV2.PrjPCB, OdbCache.cfg, PowerSupply.SchDoc, PowerSupplyV2.PcbDoc, pins.csv, vcomp2id.csv, vias.csv, vpin2pin.csv]
2021-02-17 Add Net schematic. Partial implementation
    [Control.SchDoc, KeetV2.PrjPCB, Net.SchDoc]
2021-02-18 migliorata simulazione. aggiunto modello 3D scheda power nella schedaprogrammazione
    [OdbCache.cfg, Program_interface_V2.PcbDoc, pins.csv, vcomp2id.csv, vias.csv, vpin2pin.csv, vpins.csv]
2021-02-18 aggiunta una via
    [Net.SchDoc, OdbCache.cfg, pins.csv, vias.csv, vpins.csv]
2021-02-21 piccole modifiche. aggiunti vari pdf su grounding
    [OdbCache.cfg, PowerSupplyV2.PcbDoc]
2021-02-22 chiamata con gulli. considerazioni sulla scheda di programmazione.
    [Net.SchDoc, OdbCache.cfg, PowerSupplyV2.PcbDoc, Program_interface_V2.PcbDoc, interface.SchDoc, pins.csv, vias.csv, vpins.csv]
2021-02-23 finita scheda di programmazione
    aggiunta una via sulla power
    [OdbCache.cfg, PowerSupplyV2.PcbDoc, Program_interface_V2.PcbDoc, interface.SchDoc, pins.csv, vias.csv, vpins.csv]
2021-02-24 Aggiunti gerber files
    [KeetV2.PrjPCB, PowerSupplyV2.PcbDoc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]
2021-03-04 big changes: create multi board project
    ho creato il l'ambiente per gestire più board. Ho creato il progetto Net, e ho iniziato a creare manualmente i footprint: mi manca solo quello della memoria e della ferrite
    [BOM-per-assemblatore.xlsx, BomTemplate.xls, KeetV2.PrjPCB, KeetV2.SchLib, KeetV2.csv, KeetV2.xls, KeetV2.xlsx, Net.PcbDoc]
2021-03-06 aggiunto footprint e componenti scheda di rete
    [KeetV2.PcbLib, KeetV2.PrjPCB, KeetV2.SchLib, Net.PcbDoc, Net.PrjPcb, Net.SchDoc, PowerSupplyV2.PcbDoc]
2021-03-07 aggiunti vari footprint e componenti
    [KeetV2.PcbLib, KeetV2.SchLib, Net.PcbDoc, Net.SchDoc, PowerSupplyV2.PcbDoc, SIM868e_3D.STEP]
2021-03-07 aggiunti nuovi componenti. fix di un mio errore
    [2337019-1.stp, KeetV2.PcbLib, KeetV2.SchLib, Net.PcbDoc, Net.SchDoc]
2021-03-08 minore changes
    [KeetV2.PcbLib, KeetV2.SchLib, Net.PcbDoc, Net.SchDoc]
2021-03-09 aggiunti alcuni componenti
    [KeetV2.PcbLib, KeetV2.SchLib, Net.PcbDoc, Net.SchDoc]
2021-03-10 modificato grafica connettore OBD
    [KeetV2.PcbLib, connettore_OBD_pin_invertiti.SLDASM, connettore_OBD_pin_invertiti.SLDPRT, parte_dell_obdCR-PG016.SLDPRT]
2021-03-13 valutazioni su scheda di rete con gulli
    [KeetV2.PcbLib, KeetV2.SchLib, Net.PcbDoc, Net.SchDoc]
2021-03-13 sistemate alcune cose sulla scheda di rete
    [Net.PcbDoc, Net.SchDoc]
2021-03-13 fix minori
    [Net.PcbDoc, Net.PrjPcb]
2021-03-14 piccole modifiche alla scheda di rete
    [Net.PcbDoc, Net.SchDoc]
2021-03-15 aggiunta della serigrafia e il filtro SAW
    [KeetV2.PcbLib, KeetV2.SchLib, Net.PcbDoc, Net.SchDoc]
2021-03-16 aggiunta antenna bluetooth
    [Net.PcbDoc, Net.SchDoc]
